jbrzusto/usrp_marine_radar/pix/usrp1_vs_usrp2_layout.jpg

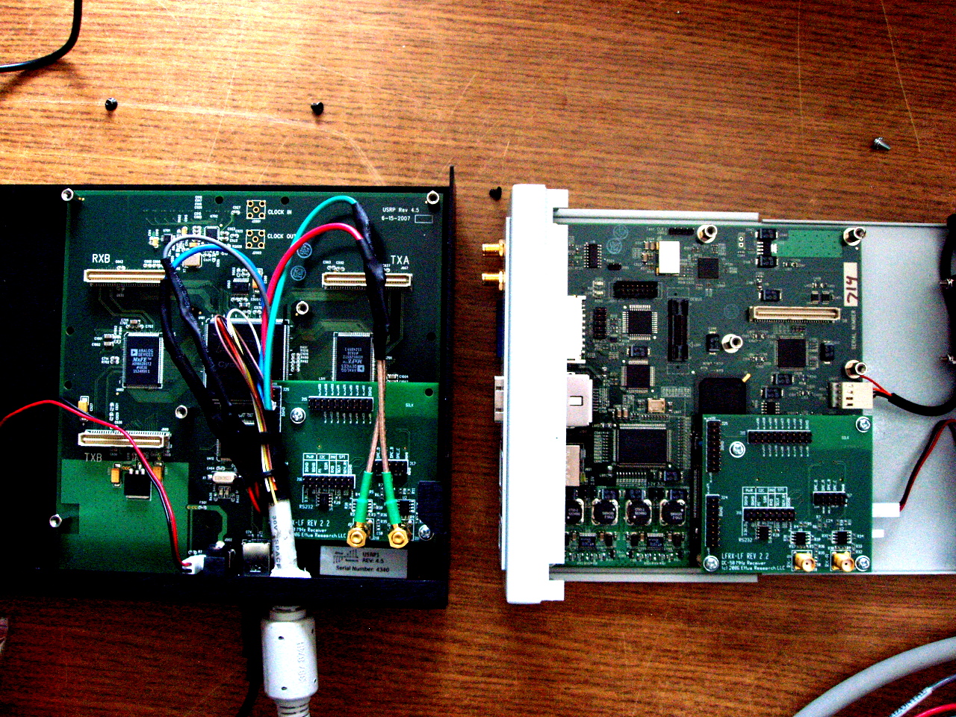
pix/usrp1_vs_usrp2_layout.jpg
