jbrzusto/usrp_marine_radar/pix/lfrx_1_flat.jpg

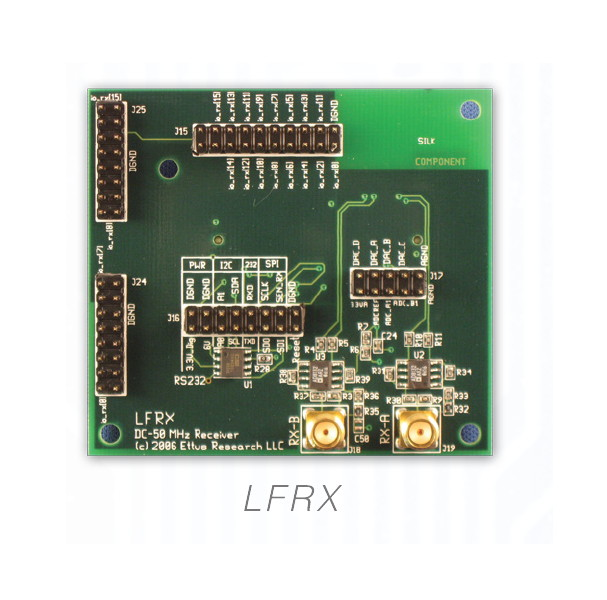
pix/lfrx_1_flat.jpg
