jbrzusto/usrp_marine_radar/pix/dual_LFRX_USRP1_configuration.jpg

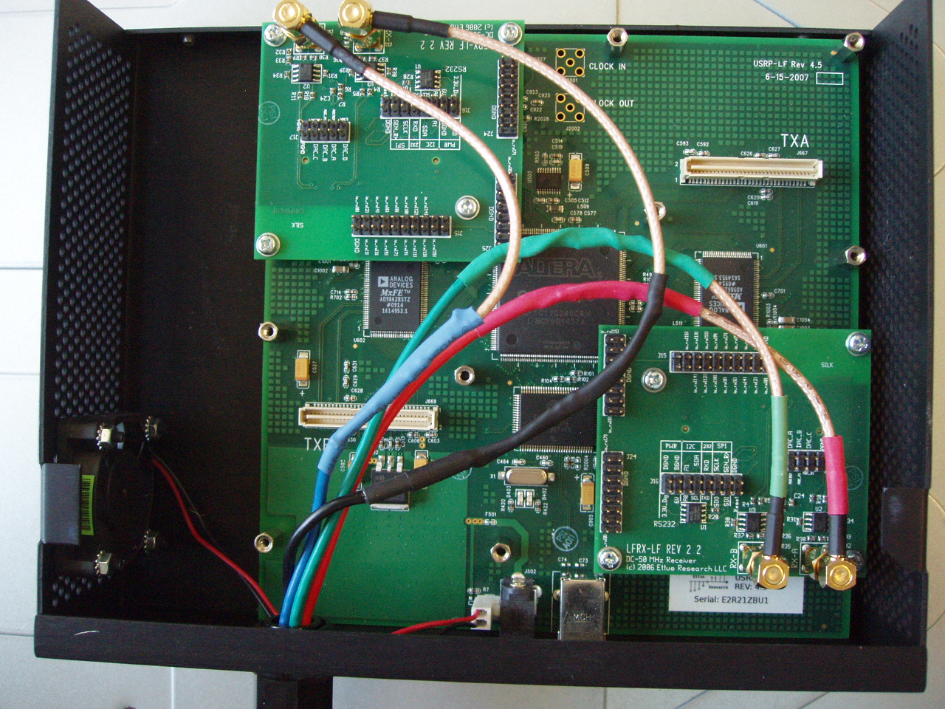
pix/dual_LFRX_USRP1_configuration.jpg
