jbrzusto/usrp_marine_radar/pix/LFRX_1.jpg

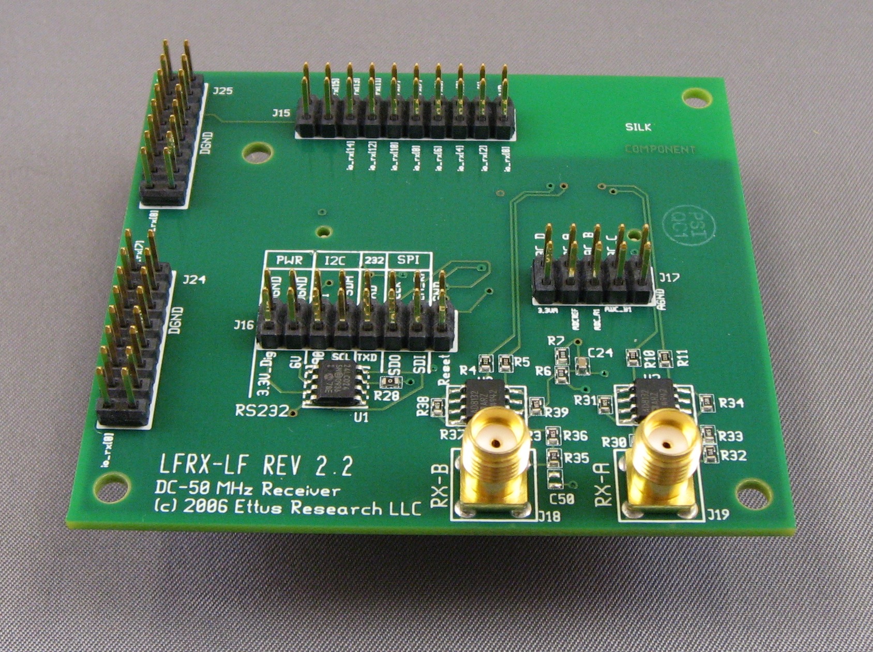
pix/LFRX_1.jpg
