jbrzusto/usrp_marine_radar/pix/lfrx_as_radar_digitizing_interface.png

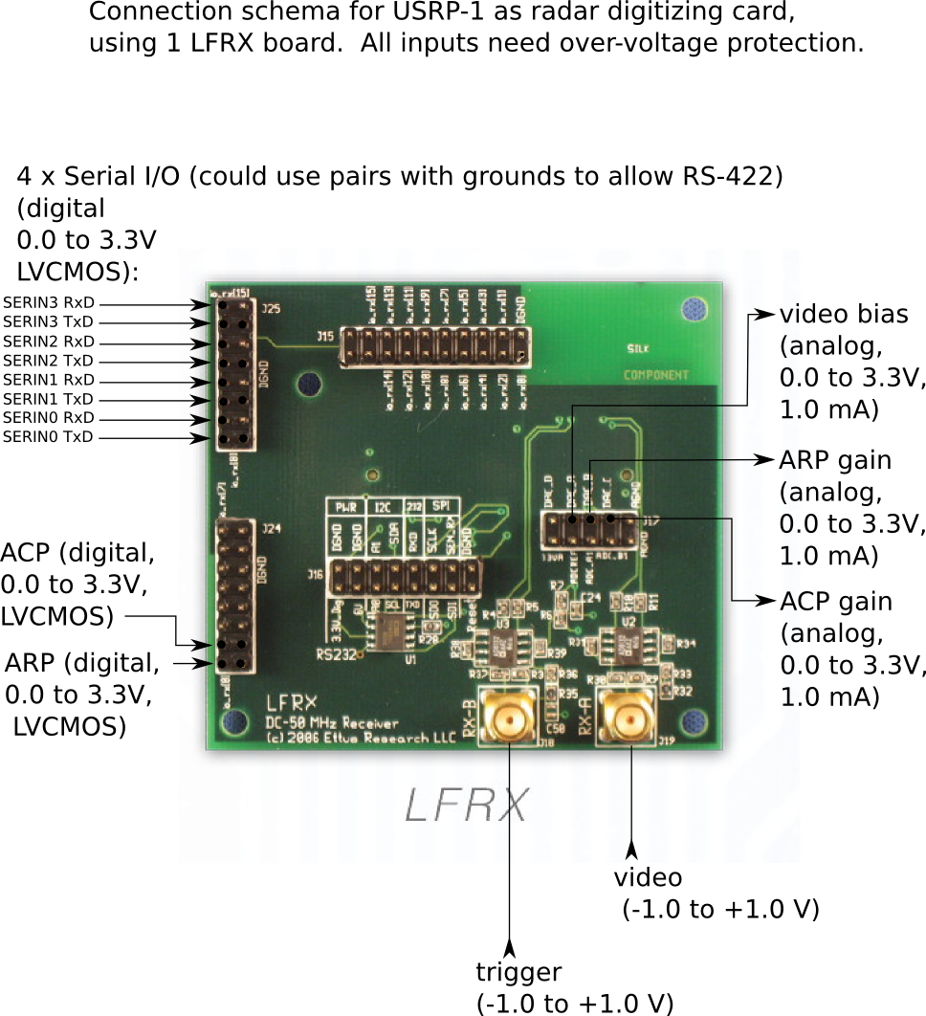
pix/lfrx_as_radar_digitizing_interface.png
