jbrzusto/usrp_marine_radar/pix/lfrx_usrp1_as_radar_digitizer_version2.png

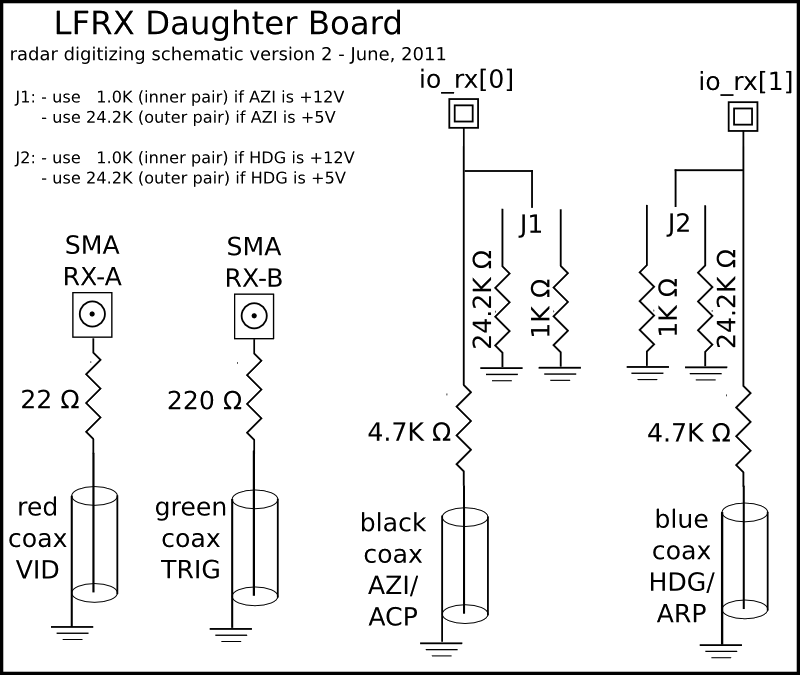
pix/lfrx_usrp1_as_radar_digitizer_version2.png
