jbrzusto/usrp_marine_radar/pix/modified_daughter_board_with_pot_on_HDG.JPG

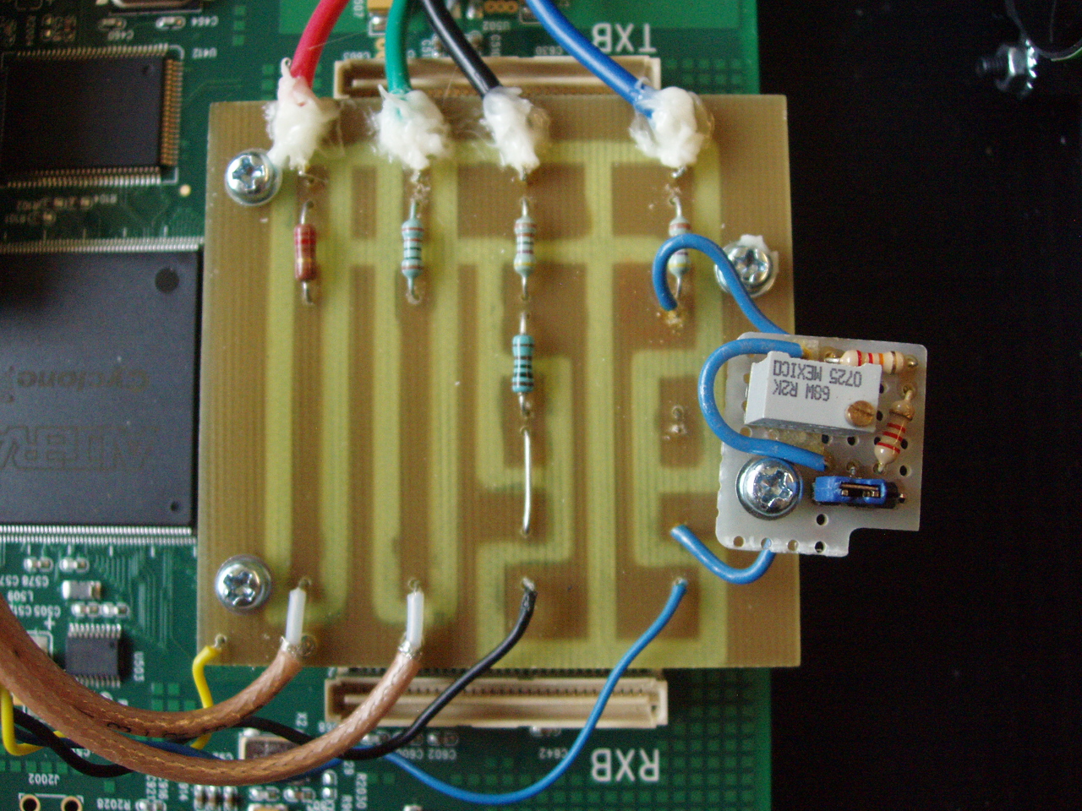
pix/modified_daughter_board_with_pot_on_HDG.JPG
