jbrzusto/usrp_marine_radar/pix/radR_usrp_plugin_windows_screenshot.png

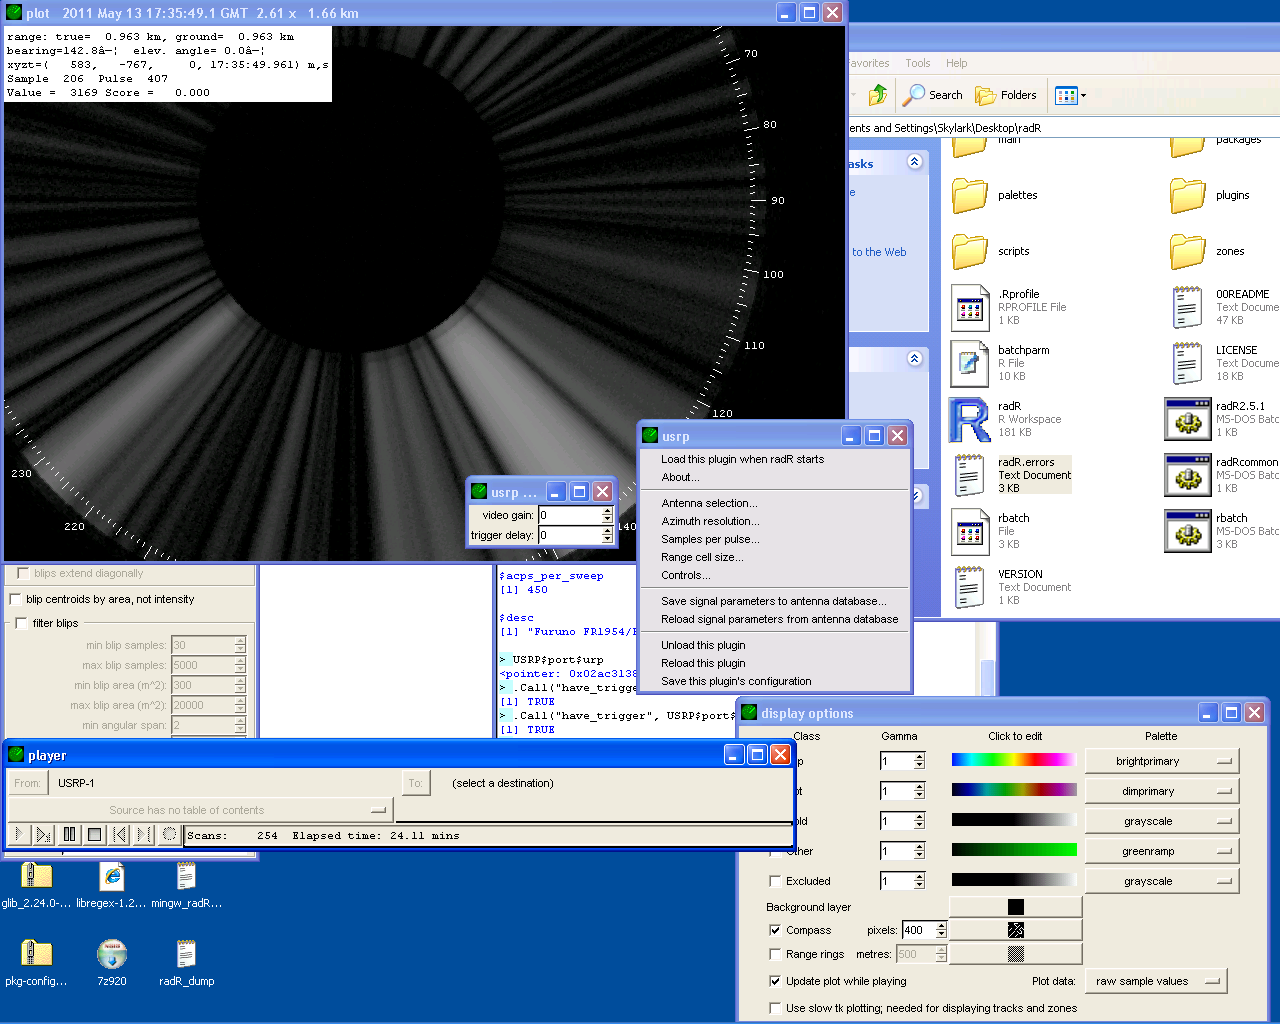
pix/radR_usrp_plugin_windows_screenshot.png
