jbrzusto/usrp_marine_radar/pix/sample_blipmovie_4kx4k_screenshot.png

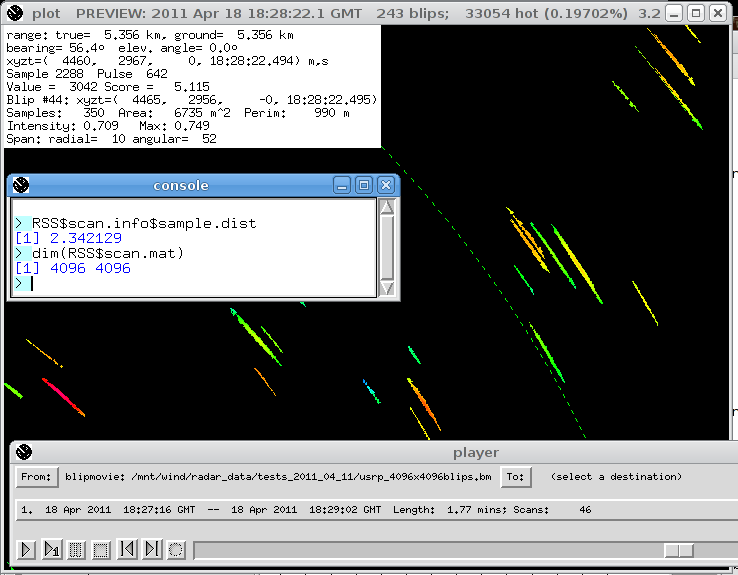
pix/sample_blipmovie_4kx4k_screenshot.png
