jbrzusto/usrp_marine_radar/pix/usrp1_as_radar_digitizer.png

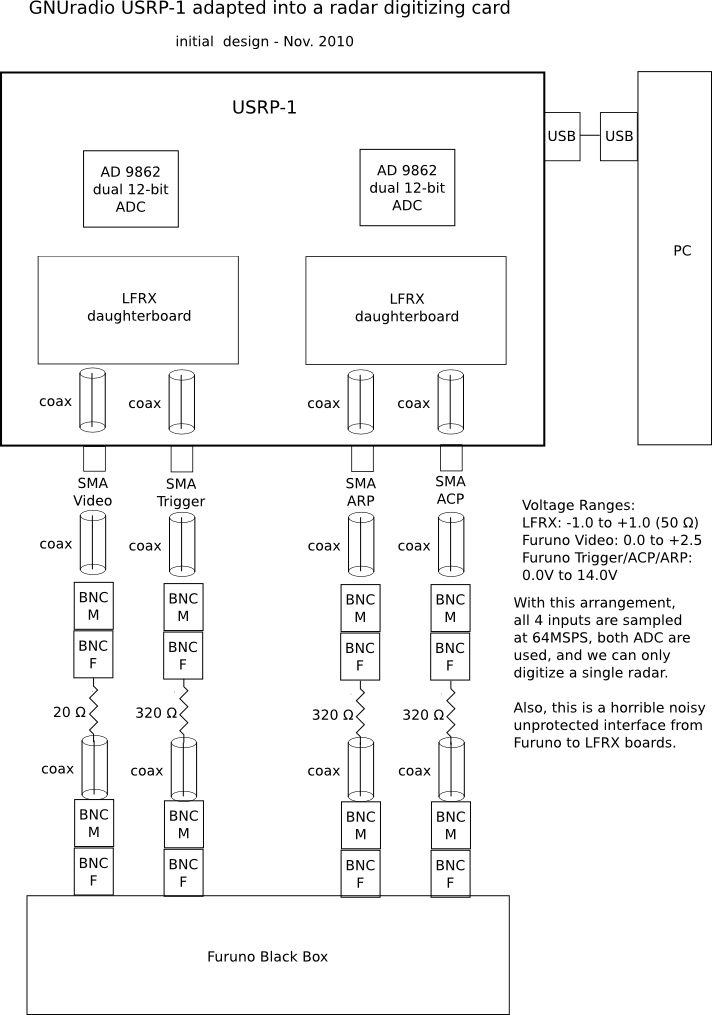
pix/usrp1_as_radar_digitizer.png
