jbrzusto/usrp_marine_radar/pix/usrp_front_panel_connections.jpg

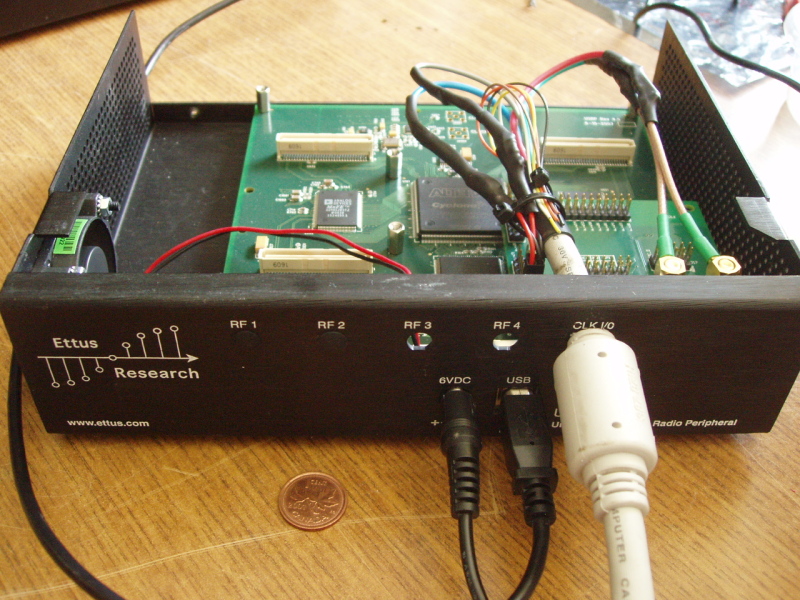
pix/usrp_front_panel_connections.jpg
