jbrzusto/usrp_marine_radar/pix/usrp_inside_with_lfrx_and_cabling.jpg

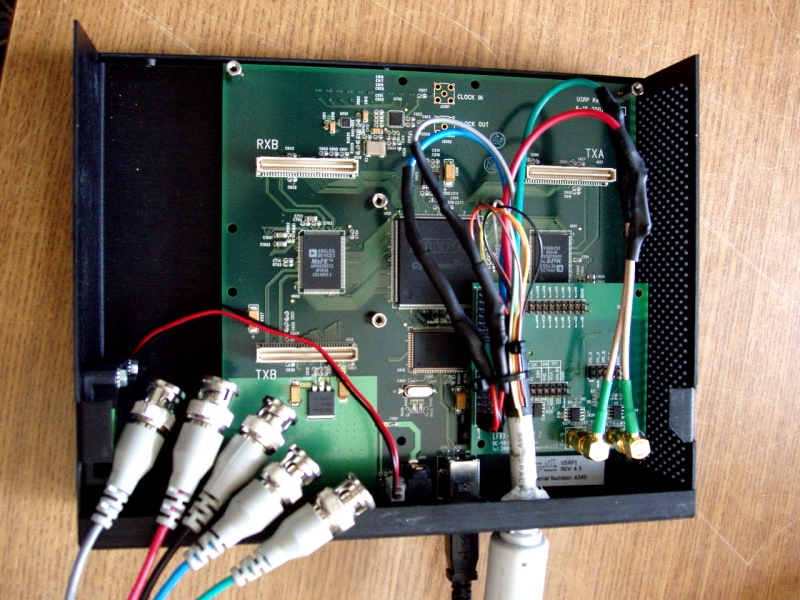
pix/usrp_inside_with_lfrx_and_cabling.jpg
