jbrzusto/usrp_marine_radar/fpga/usrp1/sdr_lib/trigger_gen.v

// -*- verilog -*-
//
//  USRP - Universal Software Radio Peripheral
//
//  Copyright (C) 2010 John Brzustowski
//
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
// Generate a trigger a fixed delay after the signal crosses an excitation
// threshold after having crossed a relaxation threshold.  The threshold
// values are independent, and when unequal, "crossing" a threshold means
// being found at or beyond it in the direction away from the other threshold.
// If the thresholds are equal, a positive crossing is treated as excitation,
// a negative crossing as relaxation.
// If a non-zero latency is specified, then at least that number of clock ticks 
// must elapse between consecutive relaxation and excitation events.
// The count of ticks since the most recent excitation is maintained in register "age".
// The count of ticks since the most recent relaxation is maintained in register "relax_age".
// The delay value does not affect the sequence of "age" or "relax_age" values, but
// is merely the age at which an excitation causes output "trigger" to be asserted.

// Timing:  if the input at clock pulse N crosses the excitation threshold after
// a crossing of the relaxation threshold, then the trigger output is high
// at the start of the clock pulse N+1+delay.
//
// The trigger is only held high for one clock.

// mode M1:  thresh_relax < thresh_excite (usual situation)

`define TS_M1_WAITING_RELAX     3'd0  // waiting for signal to cross threshold in relaxation direction
`define TS_M1_WAITING_EXCITE    3'd1  // waiting for signal to cross threshold in excitation direction

// mode M2:  thresh_relax > thresh_excite (inverted signal)

`define TS_M2_WAITING_RELAX     3'd2  // waiting for signal to cross threshold in relaxation direction
`define TS_M2_WAITING_EXCITE    3'd3  // waiting for signal to cross threshold in excitation direction

// mode M3:  thresh_relax == thresh_excite (single threshold; crossing upward is excitation)

`define TS_M3_WAITING_RELAX     3'd4  // waiting for signal to cross threshold in relaxation direction
`define TS_M3_WAITING_EXCITE    3'd5  // waiting for signal to cross threshold in excitation direction

`define TS_DELAYING             3'd6  // threshold crossed; delaying before triggering

module trigger_gen 
  ( input clock,
    input reset,
    input enable,
    input [width-1:0] signal,
    input [width-1:0] thresh_relax,
    input [width-1:0] thresh_excite,
    input [delay_width-1:0] delay,
    input [age_width-1:0] latency,
    input 		    always_trigger,
    output reg 		    trigger,
    output reg [counter_width-1:0] counter,
    output reg [age_width-1:0] 	   age, // number of clock ticks since reset or assertion of trigger
    output reg [age_width-1:0]     prev_interval // number of clock ticks between most recent consecutive triggers; undefined until 2nd trigger pulse has been detected.
    );
   
   parameter width = 12;
   parameter delay_width = 16;
   parameter counter_width = 32;
   parameter age_width = 32;
   parameter do_smoothing = 1;
   
   reg [2:0] 			   state;
   reg [delay_width-1:0] 	   delay_counter;
   reg [width-1:0] 		   sig_smoothed; // possibly smoothed version of signal_in
   reg [age_width-1:0] 		   relax_age;    // how long since trigger crossed relaxation threshold?

   // smooth the signal with an IIR filter:  smooth[i+1] <= (7 * smooth[i] + value[i+1]) / 8
   // FIXME: make the weighting a control parameter, instead of hardwiring 7/8, 1/8.

   wire [3 + width - 1:0] 	   smoother = {{sig_smoothed, 3'b0} - {3'b0, sig_smoothed} + {3'b0, signal}};
   
   always @(posedge clock)
     if (reset | ~enable)
       begin
	  if (thresh_relax < thresh_excite)
	    state <= #1 `TS_M1_WAITING_RELAX;
	  else if (thresh_relax > thresh_excite)
	    state <= #1 `TS_M2_WAITING_RELAX;
	  else
	    state <= #1 `TS_M3_WAITING_RELAX;
	  trigger <=  1'b0;
	  counter <= #1 1'b0;
	  sig_smoothed <= #1 signal;
	  age <= #1 1'b0;
	  relax_age <= #1 1'b0;
	  prev_interval <= #1 1'b0;
       end
     else
       begin	  
	  age = age + 1'b1;              // NB: blocking assign
	  relax_age =  relax_age + 1'b1; // NB: blocking assign 
	  
	  sig_smoothed <= #1 do_smoothing ? smoother[3 + width - 1 : 3] : signal;
	  
	  case (state)
	    `TS_M1_WAITING_RELAX:
	      begin
		 trigger <= #1 1'b0;
		 if (age >= latency && sig_smoothed <= thresh_relax)
		   begin
		      state <= #1 `TS_M1_WAITING_EXCITE;
		      relax_age <= #1 1'b0;
		   end
	      end
	    
	    `TS_M1_WAITING_EXCITE:
	      begin
		 if (relax_age >= latency && sig_smoothed >= thresh_excite)
		   begin
		      prev_interval <= #1 age;
		      age <= #1 1'b0;
		      counter <= #1 counter + 1'b1;
		      if (delay == 0)
			begin
			   state <= #1 `TS_M1_WAITING_RELAX;
			   trigger <= #1 1'b1;
			end
		      else
			begin
			   state <= #1 `TS_DELAYING;
			   delay_counter <= #1 delay;
			   trigger <= #1 1'b0; // redundant
			end
		   end
	      end
	    
	    `TS_M2_WAITING_RELAX:
	      begin
		 trigger <= #1 1'b0;
		 if (age >= latency && sig_smoothed >= thresh_relax)
		   begin
		      state <= #1 `TS_M2_WAITING_EXCITE;
		      relax_age <= #1 1'b0;
		   end
	      end
	    
	    `TS_M2_WAITING_EXCITE:
	      begin
		 if (relax_age >= latency && sig_smoothed <= thresh_excite)
		   begin
		      prev_interval <= #1 age;
		      age <= #1 1'b0;
		      counter <= #1 counter + 1'b1;
		      if (delay == 0)
			begin
			   state <= #1 `TS_M2_WAITING_RELAX;
			   trigger <= #1 1'b1;
			end
		      else
			begin
			   state <= #1 `TS_DELAYING;
			   delay_counter <= #1 delay;
			   trigger <= #1 1'b0; // redundant
			end
		   end
	      end
	    
	    `TS_M3_WAITING_RELAX:
	      begin
		 trigger <= #1 1'b0;
		 if (age >= latency && sig_smoothed < thresh_relax)
		   begin
		      state <= #1 `TS_M3_WAITING_EXCITE;
		      relax_age <= #1 1'b0;
		   end
	      end
	    
	    `TS_M3_WAITING_EXCITE:
	      begin
		 if (relax_age >= latency && sig_smoothed > thresh_excite)
		   begin
		      prev_interval <= #1 age;
		      age <= #1 1'b0;
		      counter <= #1 counter + 1'b1;
		      if (delay == 0)
			begin
			   state <= #1 `TS_M3_WAITING_RELAX;
			   trigger <= #1 1'b1;
			end
		      else
			begin
			   state <= #1 `TS_DELAYING;
			   delay_counter <= #1 delay;
			   trigger <= #1 1'b0; // redundant
			end
		   end
	      end
	    
	    `TS_DELAYING:
	      if (delay_counter <= 1) // really, should never be zero here.
		begin
		   if (thresh_relax < thresh_excite)
		     state <= #1 `TS_M1_WAITING_RELAX;
		   else if (thresh_relax > thresh_excite)
		     state <= #1 `TS_M2_WAITING_RELAX;
		   else
		     state <= #1 `TS_M3_WAITING_RELAX;
		   counter <= #1 counter + 1'b1;
		   trigger <= #1 1'b1;
		end
	      else
		begin
		   delay_counter <= #1 delay_counter - 1'b1;
		end
	  endcase // case (state)
       end
endmodule // trigger_gen
