jbrzusto/usrp_marine_radar/fpga/usrp1/sdr_lib/buffer_with_header.v

// -*- verilog -*-
//
//  USRP - Universal Software Radio Peripheral
//
//  Copyright (C) 2010 John Brzustowski
//
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

// Buffer that packs metadata into high-order bits of sample words.
//
// meta[127:0], sample[15:0][n]
// -> {meta[3:0], sample[11:0][0]},
//    {meta[7:4], sample[11:0][1]},
//    ...,
//    {meta[127:124], sample[11:0][31]},
//    {0, 0, 0, 0,    sample[11:0][32]},
//    {0, 0, 0, 0,    sample[11:0][33]},
//    ...,
//    {0, 0, 0, 0,    sample[11:0][n-1]}

module buffer_with_header
  (clock,reset,enable,init,data_in,strobe_in,meta_data,data_out,strobe_out);
   
   parameter data_width = 16;
   parameter data_width_used = 12; // must be less than data_width!
   parameter meta_data_width = 128;
   
`define pack_width (data_width - data_width_used)
`define num_packs meta_data_width / `pack_width
   
   input clock;
   input reset;
   input enable;
   input init;
   input [data_width-1:0]      data_in;
   input 		       strobe_in;
   input [meta_data_width-1:0] meta_data;
   output reg [data_width-1:0] data_out;
   output reg 		       strobe_out;
   
   reg [meta_data_width-1:0]   hold_meta;
   
   always @(posedge clock)
     if(reset | ~enable)
       begin
	  strobe_out <= #1 0;
       end
     else if (init)
       begin
	  hold_meta <= #1 meta_data;
	  strobe_out <= #1 0;
       end
     else if (strobe_in)
       begin
	  data_out <= #1 {hold_meta[`pack_width - 1:0], data_in[data_width_used - 1:0]};
	  hold_meta <= #1 hold_meta >> `pack_width;
	  strobe_out <= #1 1;
       end
     else
       strobe_out <= #1 0;
   
endmodule // buffer_with_header
