jbrzusto/usrp_marine_radar/fpga/usrp1/sdr_lib/io_pins.v

// -*- verilog -*-
//
//  USRP - Universal Software Radio Peripheral
//
//  Copyright (C) 2005,2006 Matt Ettus
//  Copyright (C) 2010-2012 John Brzustowski
//
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

`include "../include/fpga_regs_common.v"
`include "../include/fpga_regs_marine_radar.v"

module io_pins
  ( inout wire [15:0] io_0, inout wire [15:0] io_1, inout wire [15:0] io_2, inout wire [15:0] io_3,
    input wire [15:0] reg_0, input wire [15:0] reg_1, input wire [15:0] reg_2, input wire [15:0] reg_3,
    input clock, input rx_reset, input tx_reset,
    input [6:0] serial_addr, input [31:0] serial_data, input serial_strobe);
   
   reg [15:0] io_0_oe,io_1_oe,io_2_oe,io_3_oe;
   
   bidir_reg bidir_reg_0 (.tristate(io_0),.oe(io_0_oe),.reg_val(reg_0));
   bidir_reg bidir_reg_1 (.tristate(io_1),.oe(io_1_oe),.reg_val(reg_1));
   bidir_reg bidir_reg_2 (.tristate(io_2),.oe(io_2_oe),.reg_val(reg_2));
   bidir_reg bidir_reg_3 (.tristate(io_3),.oe(io_3_oe),.reg_val(reg_3));
   
   // Upper 16 bits are mask for lower 16
   always @(posedge clock)
     if(serial_strobe)
       case(serial_addr)
	 `FR_OE_0 : io_0_oe
	   <= #1 (io_0_oe & ~serial_data[31:16]) | (serial_data[15:0] & serial_data[31:16] );
	 `FR_OE_1 : io_1_oe
	   <= #1 (io_1_oe & ~serial_data[31:16]) | (serial_data[15:0] & serial_data[31:16] );
	 `FR_OE_2 : io_2_oe
	   <= #1 (io_2_oe & ~serial_data[31:16]) | (serial_data[15:0] & serial_data[31:16] );
	 `FR_OE_3 : io_3_oe
	   <= #1 (io_3_oe & ~serial_data[31:16]) | (serial_data[15:0] & serial_data[31:16] );
       endcase // case(serial_addr)

endmodule // io_pins
