jbrzusto/usrp_marine_radar/(commit log)

2012-04-17 - add schematic of new resistor ladder front end with selectable voltages
2012-05-01 new change to LFRX front end board, with photo
