jbrzusto/usrp_marine_radar/(notices)

Notices in the files:
src/pulse_buffer.h:
GNU Radio is free software; you can redistribute it and/or modify
it under the terms of the GNU General Public License as published by
the Free Software Foundation; either version 3, or (at your option)
fpga/usrp1/sdr_lib/buffer_with_header.v:
This program is free software; you can redistribute it and/or modify
the Free Software Foundation; either version 2 of the License, or
(at your option) any later version.
